chisatohojo/Hotori/hardware/cad/README.md

# Hotori CAD

Fusion 360の設計データを保存するフォルダです。
