chisatohojo/Hotori/nekocat_ESP32_Arduino_UART_spec_v0.3.xlsx

Sheet: 01_通信フレーム
ねこ制御 UART通信仕様 v0.3（案）
ESP32 → Arduino ｜ 動作変更時のみ送信 ｜ 9バイト固定 ｜ グループ別更新
通信基本仕様
通信方向 | ESP32 → Arduino | 物理通信 | UART 8N1 | 速度 | 115200 bps
送信タイミング | 動作変更時のみ | 更新方式 | FLAGSで対象指定 | フレーム長 | 9 byte固定
送信対象 | 音声・呼吸・尻尾 | 指示の実行 | Arduino側 | 受信なし | 設定状態を維持
状態初期化 | 起動時は全停止 | 初期指示 | ESP32起動時に全状態送信 | 送信確認 | ACKなし（片方向）
送信フレーム配置（左から順に送信）
Byte | フィールド | 長さ | 有効値／固定値 | 更新対象 | 説明
1 | HEADER1 | 1 | 0xAA | ― | フレーム開始識別1
2 | HEADER2 | 1 | 0x55 | ― | フレーム開始識別2
3 | FLAGS | 1 | 0x01～0x07 | ― | 更新する動作グループを指定（0x00は送信しない）
4 | VOICE | 1 | 0～254 | bit 0 | 音声ID、0＝停止
5 | BREATH | 1 | 0～60 | bit 1 | 呼吸速度、0＝停止、1～60＝回/分
6 | TAIL_DIR | 1 | 0～3 | bit 2 | 0＝停止、1＝左、2＝右、3＝左右交互
7 | TAIL_SPEED | 1 | 0～100 | bit 2 | 0＝停止、1～100＝速度指令[%]
8 | TAIL_TIME | 1 | 0～255 | bit 2 | 0＝停止、1～255＝0.1秒単位
9 | CRC8 | 1 | 0x00～0xFF | ― | Byte 3～8に対するCRC-8
注意：上記の数値範囲・音声ID等は v0.3の暫定案。機構・音源確定後に必要に応じて改訂する。

Sheet: 02_パラメータ定義
パラメータ定義
FLAGSで更新対象になっているフィールドだけArduinoが反映。指定されていないフィールドは保持する。
フィールド | Byte | 単位 | 通常設定値 | 特別な値 | 説明 | 無効・予約値
VOICE | 4 | 音声ID | 1～254 | 0＝停止 | 受信時に指定音声を再生。同じIDを再度受信しても新たに再生する。 | 255＝予約
BREATH | 5 | 回/分 | 1～60 | 0＝停止 | 1分あたりの呼吸回数。次の呼吸更新まで設定を維持する。 | 61～255＝無効
TAIL_DIR | 6 | 列挙値 | 1＝左／2＝右／3＝左右交互 | 0＝停止 | 尻尾の動作方向を指定。速度と時間を合わせて1グループとして更新。 | 4～255＝無効
TAIL_SPEED | 7 | %指令 | 1～100 | 0＝停止 | モータPWMそのものではなく、Arduino側の安全範囲に対する速度指令。 | 101～255＝無効
TAIL_TIME | 8 | 0.1秒 | 1～255（0.1～25.5秒） | 0＝停止 | 指定時間経過でArduinoが尻尾を自動停止。 | なし
FLAGS | 3 | ビット | 0x01～0x07 | 0x00＝送信しない | bit0=音声、bit1=呼吸、bit2=尻尾。bit3～7は常に0。 | 0x08～0xFF＝予約ビットあり
CRC8 | 9 | 検査値 | 0x00～0xFF | ― | CRC-8/SMBUS相当（poly=0x07, init=0, 非反射, xorout=0）。Byte3～8が対象。 | 不一致フレームを破棄
HEADER1 | 1 | 固定 | 0xAA | ― | 先頭の識別バイト。 | それ以外は不一致
HEADER2 | 2 | 固定 | 0x55 | ― | 2番目の識別バイト。 | それ以外は不一致

Sheet: 03_FLAGSと制御ルール
FLAGS / CRC / 受信処理ルール
通信フレームワークの解釈とArduino側で守る動作条件
FLAGSのビット割り当て
bit | マスク | 更新グループ | 1のとき | 0のとき
bit 0 | 0x01 | 鳴き声 | VOICEを新規指示として実行 | 音声に触れない
bit 1 | 0x02 | 呼吸 | BREATHを反映 | 呼吸状態を維持
bit 2 | 0x04 | 尻尾 | DIR・SPEED・TIMEを一括更新 | 尻尾状態を維持
bit 3～7 | 0xF8 | 予約 | 送信禁止／受信時は破棄 | 常に0
CRC-8計算条件
方式 | 多項式 | 初期値 | RefIn / RefOut | 最終XOR
CRC-8/SMBUS相当 | 0x07 | 0x00 | false / false | 0x00
計算対象：Byte 3 FLAGS ～ Byte 8 TAIL_TIME（計6バイト）。Byte 1・2 のヘッダとByte 9のCRC自身は除外。
Arduino受信・動作ルール
番号 | ルール
1 | ヘッダが不正、CRC不一致、予約ビットが1、対象パラメータが範囲外のフレームは破棄する。
2 | FLAGSで指定されなかったグループは更新せず、現在の状態を維持する。
3 | フレーム内で更新しないフィールドはESP32が0で埋め、Arduinoは読み飛ばす。
4 | VOICEは同じ音声IDを再受信しても再生指示として処理する。
5 | BREATHは次の更新まで設定を継続する（0なら停止）。
6 | 尻尾はTAIL_DIR、TAIL_SPEED、TAIL_TIMEのいずれかが0なら停止する。
7 | 尻尾はTIME経過でArduinoが自動停止。新しい尻尾指示は旧指示を上書きする。
8 | 通常の無通信状態は異常扱いしない。動作変更時だけ送信するため。
9 | Arduino起動直後は全停止を初期状態とし、ESP32から起動時に初期状態を送信する。
10 | 片方向通信でACKがないため、受信漏れ・ESP32再起動時の状態ずれへの対策は必要に応じて今後検討する。

Sheet: 04_通信サンプル
送信サンプル（HEX）
CRC値はByte3～8の6バイトから計算。動作指示の各値は例示用。
動作ごとのフレーム例
ケース | HEADER1 | HEADER2 | FLAGS | VOICE | BREATH | DIR | SPEED | TIME | CRC8 | 全9バイト（HEX） | 動作の解釈
全項目更新 | AA | 55 | 07 | 02 | 14 | 03 | 32 | 1E | 10 | AA 55 07 02 14 03 32 1E 10 | 音声2を再生、呼吸20回/分、尻尾は左右交互50%で3.0秒
音声だけ | AA | 55 | 01 | 03 | 00 | 00 | 00 | 00 | 8F | AA 55 01 03 00 00 00 00 8F | 音声3を再生、呼吸と尻尾は変更しない
呼吸だけ | AA | 55 | 02 | 00 | 14 | 00 | 00 | 00 | 6D | AA 55 02 00 14 00 00 00 6D | 呼吸20回/分に変更、音声と尻尾は変更しない
尻尾だけ | AA | 55 | 04 | 00 | 00 | 03 | 32 | 1E | 90 | AA 55 04 00 00 03 32 1E 90 | 尻尾は左右交互50%で3.0秒、ほかは変更しない
全停止 | AA | 55 | 07 | 00 | 00 | 00 | 00 | 00 | DF | AA 55 07 00 00 00 00 00 DF | 音声・呼吸・尻尾を停止
例：FLAGS=0x04 のフレームではVOICE/BREATH欄が0でも、その2グループは停止させず、従来状態を維持する。
