chisatohojo/Hotori/(list of files, cad)

Other CAD files:
hardware/cad/ほとり.f3d
