chisatohojo/Hotori/hotori_hardware_test/SerialCommandReader.cpp

#include "SerialCommandReader.h"

SerialCommandReader::SerialCommandReader() : length_(0), overflowed_(false) {
  buffer_[0] = '\0';
}

const char* SerialCommandReader::poll(Stream& serial) {
  while (serial.available() > 0) {
    const char input = static_cast<char>(serial.read());

    if (input == '\r') {
      continue;
    }

    if (input == '\n') {
      if (overflowed_) {
        serial.println(F("[ERROR] Command is too long."));
        length_ = 0;
        overflowed_ = false;
        return nullptr;
      }

      if (length_ == 0) {
        continue;
      }

      buffer_[length_] = '\0';
      length_ = 0;
      return buffer_;
    }

    if (length_ < BUFFER_SIZE - 1) {
      buffer_[length_++] = input;
    } else {
      overflowed_ = true;
    }
  }

  return nullptr;
}
