chisatohojo/Hotori/hotori_hardware_test/SerialCommandReader.h

#pragma once

#include <Arduino.h>

class SerialCommandReader {
 public:
  SerialCommandReader();

  // Returns a null-terminated command only when a complete line is available.
  // The returned pointer remains valid until the next call to poll().
  const char* poll(Stream& serial);

 private:
  static constexpr uint8_t BUFFER_SIZE = 24;
  char buffer_[BUFFER_SIZE];
  uint8_t length_;
  bool overflowed_;
};
