chisatohojo/Hotori/(commit log)

2026-10-03 Add Arduino Mega stepper test
2026-10-03 Add dual motor and DFPlayer hardware test
2026-10-29 Configure Hotori Arduino development environment
2026-10-29 Add ESP32 UART runtime for Mega 2560
2026-10-30 Create README.md for Hotori CAD
    Add README for Hotori CAD project with folder description.
